zbauman3/r2d2-helmet/(commit log)

2026-08-27 WIP: screen, lights, speaker, servo
2026-08-27 WIP: servo, audio patterns, scream, etc
